trrriple/teensyGpsDoV2/doc/s-l960.webp

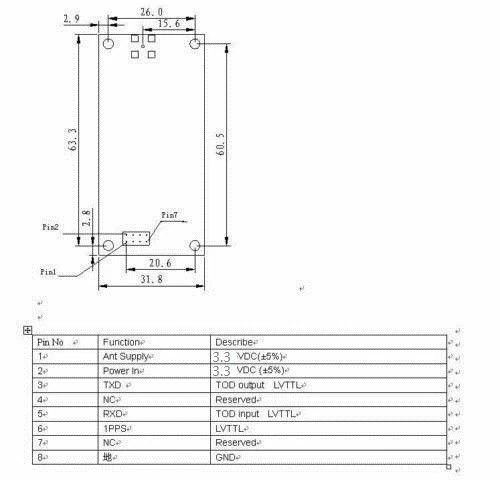
doc/s-l960.webp
