trrriple/teensyGpsDoV2/doc/s-l1600.webp

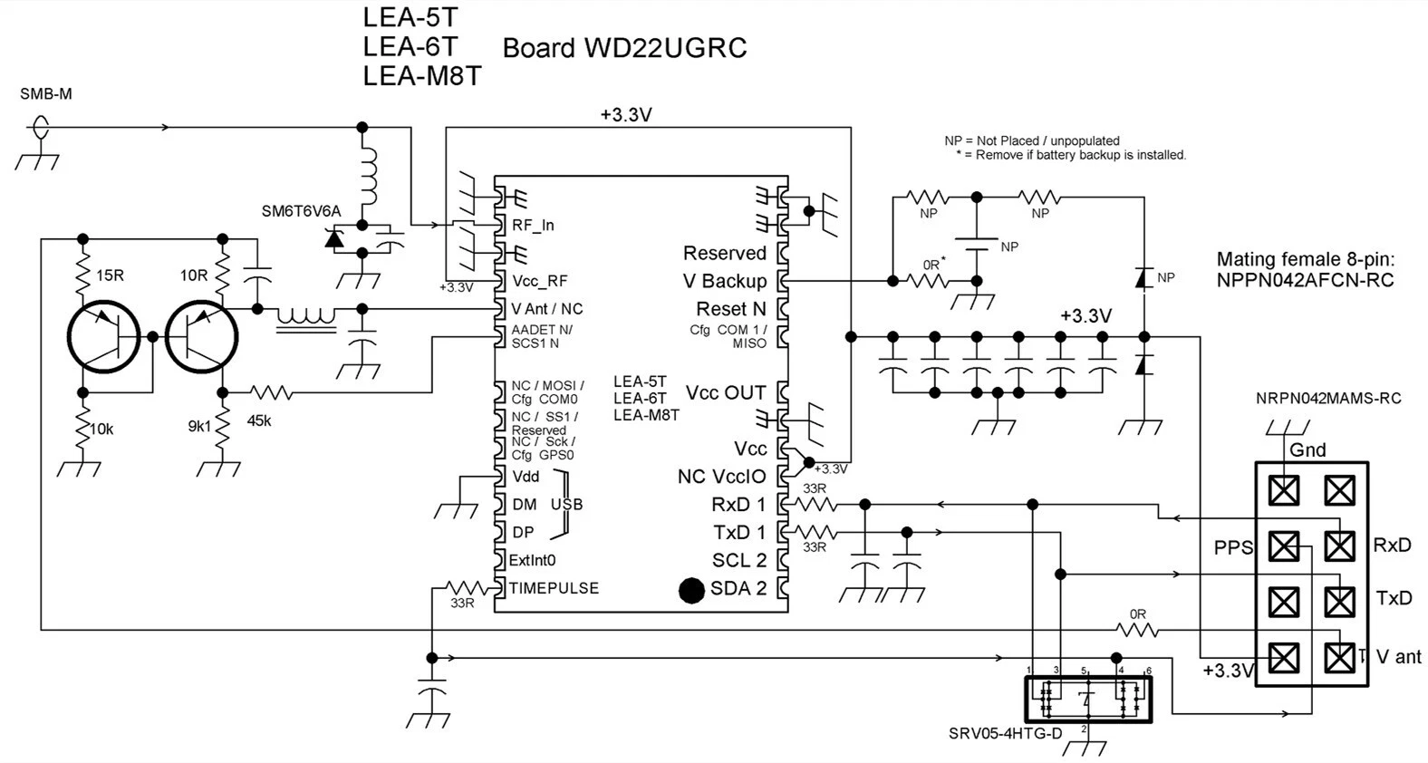
doc/s-l1600.webp
