trrriple/teensyGpsDoV2/board/teensyGpsDoV2/teensyGpsDoV2.kicad_pcb

## KiCad design board/teensyGpsDoV2/teensyGpsDoV2.kicad_pcb (2025-10-29)

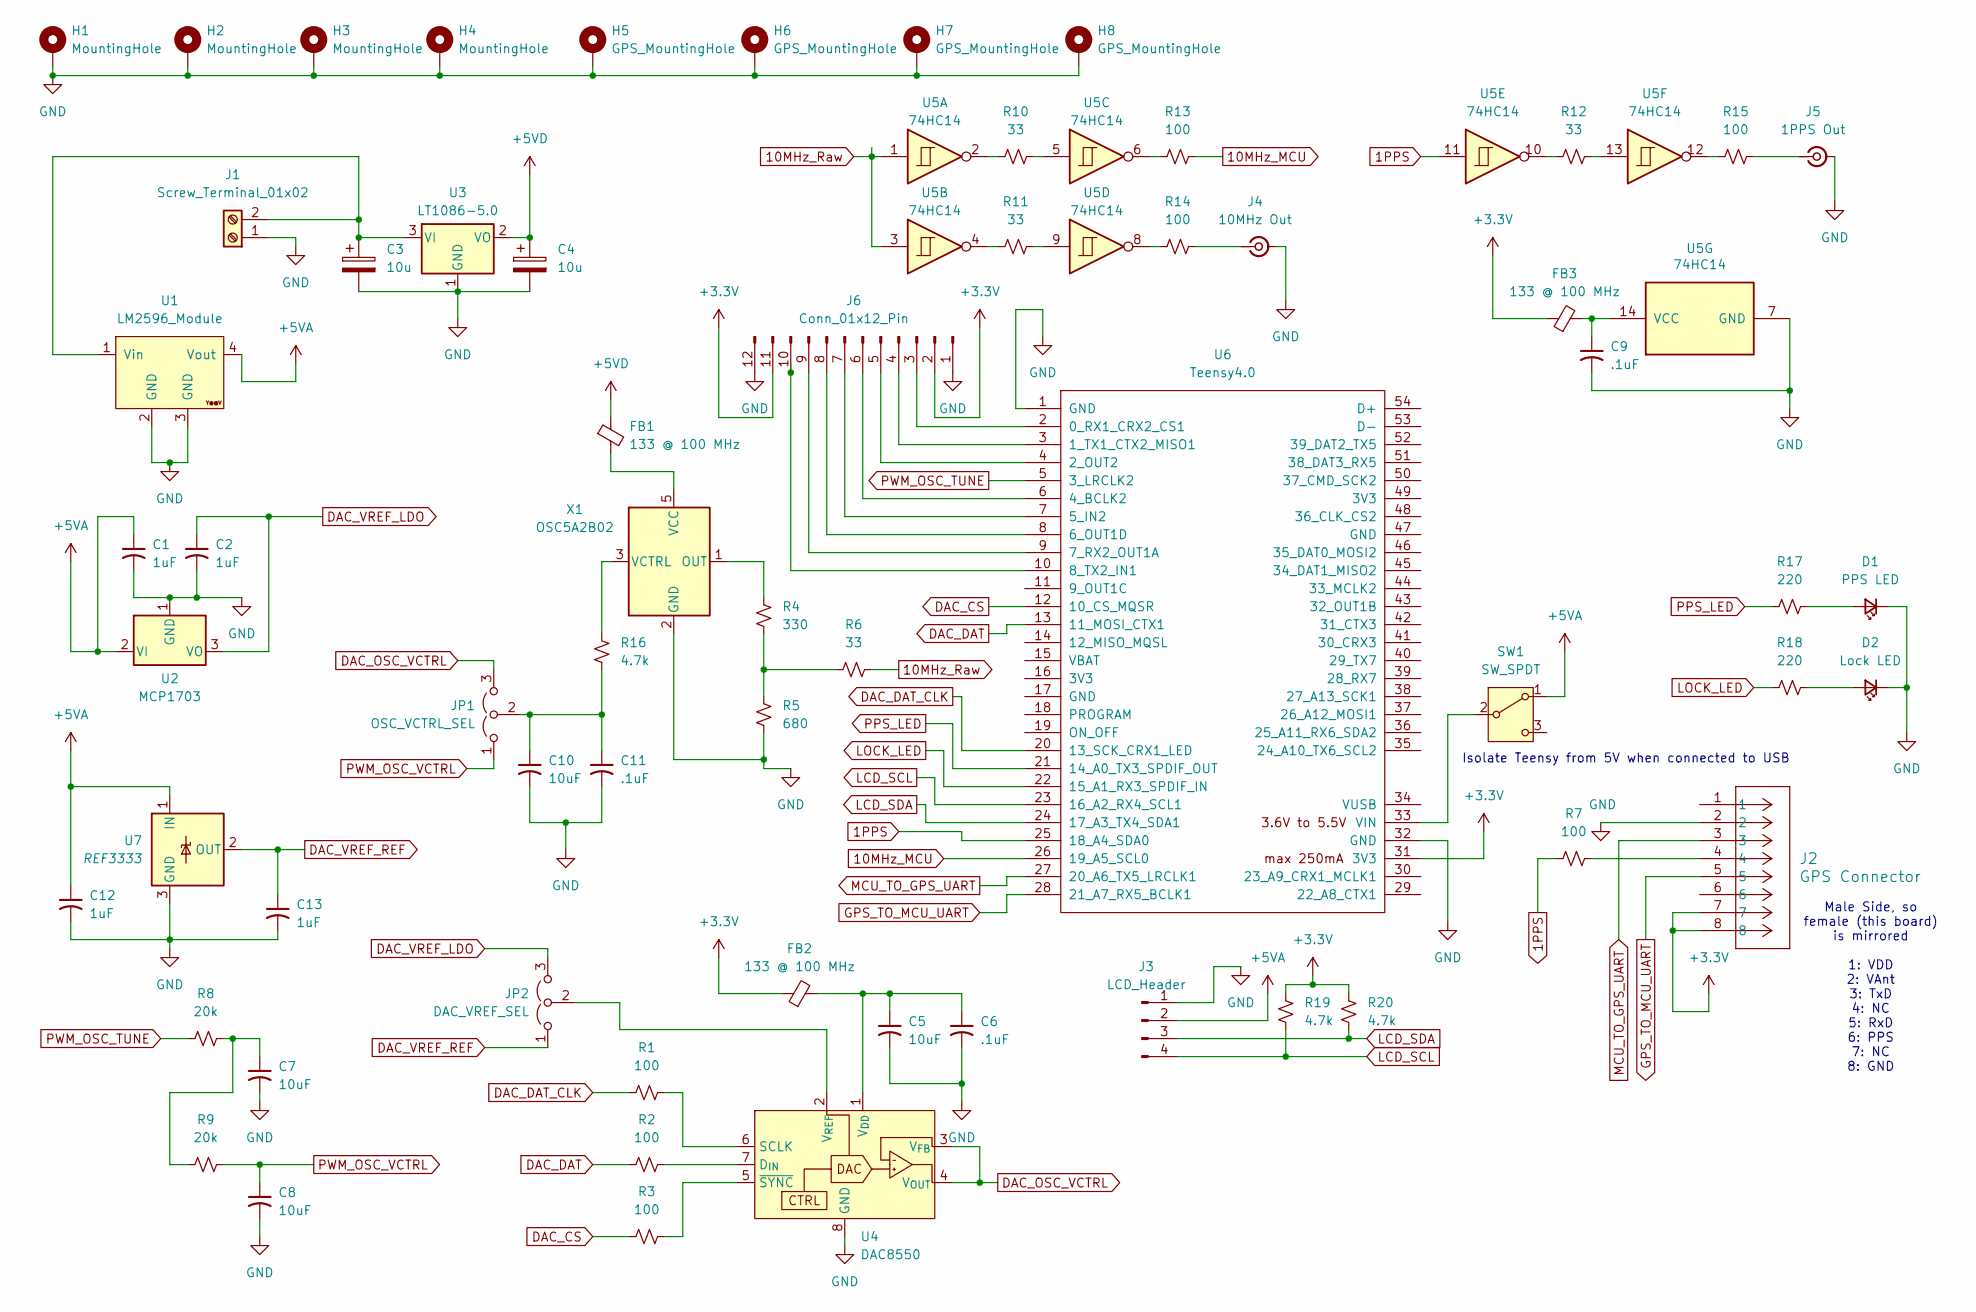
[picture p13: schematic teensyGpsDoV2.kicad_sch]

Parts:
C1, C2, C12, C13: 1uF; C_Disc_D5.0mm_W2.5mm_P5.00mm
C3, C4: 10u; CP_Radial_Tantal_D5.0mm_P5.00mm
C5, C7, C8, C10: 10uF; C_Disc_D5.0mm_W2.5mm_P5.00mm
C6, C9, C11: .1uF; C_Disc_D5.0mm_W2.5mm_P5.00mm
D1: PPS LED; LED_D5.0mm_Clear
D2: Lock LED; LED_D5.0mm_Clear
FB1, FB2, FB3: 133 @ 100 MHz; R_Axial_DIN0411_L9.9mm_D3.6mm_P12.70mm_Horizontal
H1, H2, H3, H4: MountingHole; MountingHole_3.5mm_Pad
H5, H6, H7, H8: GPS_MountingHole; MountingHole_3.2mm_M3_DIN965_Pad
J1: Screw_Terminal_01x02; TerminalBlock_MaiXu_MX126-5.0-02P_1x02_P5.00mm
J2: GPS Connector; CONN4x2_NPPN042AFCN-RC_SUL
J3: LCD_Header; PinHeader_1x04_P2.54mm_Vertical
J4: 10MHz Out; CONN_RF2-04A-T-00-50-G_ADM
J5: 1PPS Out; CONN_RF2-04A-T-00-50-G_ADM
J6: Conn_01x12_Pin; PinHeader_1x12_P2.54mm_Vertical
JP1: OSC_VCTRL_SEL; PinHeader_1x03_P2.54mm_Vertical
JP2: DAC_VREF_SEL; PinHeader_1x03_P2.54mm_Vertical
R1, R2, R3, R7, R13, R14, R15: 100; R_Axial_DIN0207_L6.3mm_D2.5mm_P10.16mm_Horizontal
R4: 330; R_Axial_DIN0207_L6.3mm_D2.5mm_P10.16mm_Horizontal
R5: 680; R_Axial_DIN0207_L6.3mm_D2.5mm_P10.16mm_Horizontal
R6, R10, R11, R12: 33; R_Axial_DIN0207_L6.3mm_D2.5mm_P10.16mm_Horizontal
R8, R9: 20k; R_Axial_DIN0207_L6.3mm_D2.5mm_P10.16mm_Horizontal
R16, R19, R20: 4.7k; R_Axial_DIN0207_L6.3mm_D2.5mm_P10.16mm_Horizontal
R17, R18: 220; R_Axial_DIN0207_L6.3mm_D2.5mm_P10.16mm_Horizontal
SW1: SW_SPDT; PinHeader_1x03_P2.54mm_Vertical
U1: LM2596_Module; YAAJ_DCDC_StepDown_LM2596
U2: MCP1703; TO-92_Inline
U3: LT1086-5.0; TO-220-3_Vertical
U4: DAC8550; VSSOP-8_3x3mm_P0.65mm
U5: 74HC14; DIP-14_W7.62mm_Socket
U6: Teensy4.0; Teensy40
U7: REF3333; SOT-23
X1: OSC5A2B02; CTI-OSC-25x25

Connections:
1PPS: R7.1, U5.11, U6.25 (18_A4_SDA0)
10MHz_MCU: R13.2, U6.26 (19_A5_SCL0)
10MHz_Raw: R6.2, U5.1, U5.3
+3.3V: FB2.1, FB3.1, J2.7, J2.8, J6.2, J6.11, R19.1, R20.1, U6.31 (3V3)
+5VA: C1.1, C12.1, J3.2, SW1.1 (A), U1.4 (Vout), U2.2 (VI), U7.1 (IN)
+5VD: C4.1, FB1.1, U3.2 (VO)
DAC_CS: R3.1, U6.12 (10_CS_MQSR)
DAC_DAT: R2.1, U6.13 (11_MOSI_CTX1)
DAC_DAT_CLK: R1.1, U6.20 (13_SCK_CRX1_LED)
DAC_OSC_VCTRL: JP1.3 (B), U4.3 (V_{FB}), U4.4 (V_{OUT})
DAC_VREF_LDO: C2.1, JP2.3 (B), U2.3 (VO)
DAC_VREF_REF: C13.1, JP2.1 (A), U7.2 (OUT)
GND: C1.2, C2.2, C3.2, C4.2, C5.2, C6.2, C7.2, C8.2, C9.2, C10.2, C11.2, C12.2, C13.2, D1.1 (K), D2.1 (K), H1.1, H2.1, H3.1, H4.1, H5.1, H6.1, H7.1, H8.1, J1.1, J2.2, J3.1, J4.2 (Ext), J5.2 (Ext), J6.1, J6.12, R5.2, U1.2 (GND), U1.3 (GND), U2.1 (GND), U3.1 (GND), U4.8 (GND), U5.7 (GND), U6.1 (GND), U6.32 (GND), U7.3 (GND), X1.2 (GND)
GPS_TO_MCU_UART: J2.5, U6.28 (21_A7_RX5_BCLK1)
LCD_SCL: J3.4, R19.2, U6.23 (16_A2_RX4_SCL1)
LCD_SDA: J3.3, R20.2, U6.24 (17_A3_TX4_SDA1)
LOCK_LED: R18.1, U6.22 (15_A1_RX3_SPDIF_IN)
MCU_TO_GPS_UART: J2.3, U6.27 (20_A6_TX5_LRCLK1)
unnamed: C7.1, R8.1, R9.1
unnamed: D1.2 (A), R17.2
unnamed: D2.2 (A), R18.2
unnamed: C3.1, J1.2, U1.1 (Vin), U3.3 (VI)
unnamed: J2.4, R7.2
unnamed: J4.1 (In), R14.2
unnamed: J5.1 (In), R15.2
unnamed: J6.3, U6.2 (0_RX1_CRX2_CS1)
unnamed: J6.4, U6.3 (1_TX1_CTX2_MISO1)
unnamed: J6.5, U6.4 (2_OUT2)
unnamed: J6.6, U6.6 (4_BCLK2)
unnamed: J6.7, U6.7 (5_IN2)
unnamed: J6.8, U6.8 (6_OUT1D)
unnamed: J6.9, U6.9 (7_RX2_OUT1A)
unnamed: J6.10, U6.10 (8_TX2_IN1)
unnamed: C10.1, C11.1, JP1.2 (C), R16.2
unnamed: JP2.2 (C), U4.2 (V_{REF})
unnamed: R4.2, R5.1, R6.1
unnamed: R10.1, U5.2
unnamed: R10.2, U5.5
unnamed: R11.1, U5.4
unnamed: R11.2, U5.9
unnamed: R12.1, U5.10
unnamed: R12.2, U5.13
unnamed: R13.1, U5.6
unnamed: R14.1, U5.8
unnamed: R15.1, U5.12
unnamed: SW1.2 (B), U6.33 (VIN)
unnamed: R2.2, U4.7 (D_{IN})
unnamed: R1.2, U4.6 (SCLK)
unnamed: C5.1, C6.1, FB2.2, U4.1 (V_{DD})
unnamed: R3.2, U4.5 (~SYNC)
unnamed: C9.1, FB3.2, U5.14 (VCC)
unnamed: R4.1, X1.1 (OUT)
unnamed: FB1.2, X1.5 (VCC)
unnamed: R16.1, X1.3 (VCTRL)
PPS_LED: R17.1, U6.21 (14_A0_TX3_SPDIF_OUT)
PWM_OSC_TUNE: R8.2, U6.5 (3_LRCLK2)
PWM_OSC_VCTRL: C8.1, JP1.1 (A), R9.2

Notes on the sheet:
Male Side, so female (this board) is mirrored 1: VDD 2: VAnt 3: TxD 4: NC 5: RxD 6: PPS 7: NC 8: GND
Isolate Teensy from 5V when connected to USB

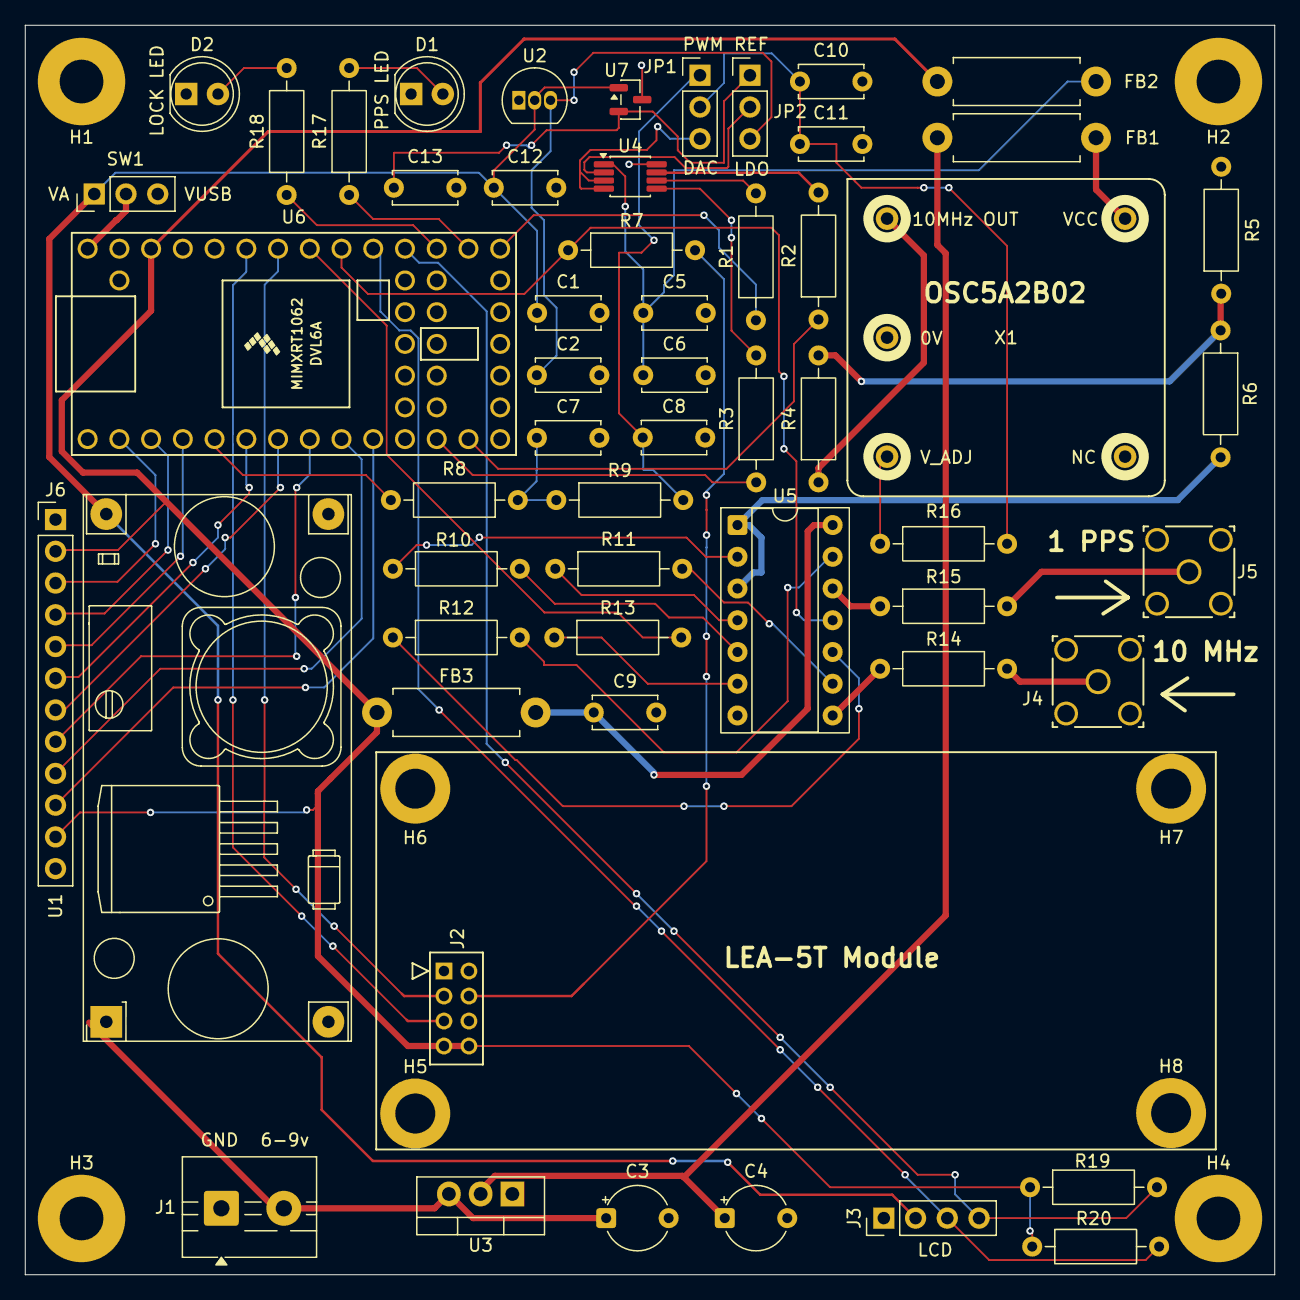
[picture p14: board teensyGpsDoV2.kicad_pcb from above]

Board: 2 copper layers, 100.0 x 100.0 mm, 63 parts (0 on the bottom side), 57 nets.
