trrriple/teensyGpsDoV2/(commit log)

2025-10-19 WIP, dac8550 and oscillator tuning implemented. Tuning filter probably needs some work
    [gnss_ubx5.cpp, gnss_ubx5.h, main.cpp]
2025-10-20 WIP schematic, WIP tuning code
    [teensyGpsDoV2.kicad_pcb, teensyGpsDoV2.kicad_sch]
2025-10-20 rework to use quad timer capture instead of interrupt
    [main.cpp]
2025-10-21 fixed bug with counter reset value, unifying console printing to one function
    [main.cpp]
2025-10-21 Schematic WIP
    [teensyGpsDoV2.kicad_sch]
2025-10-23 WIP, moved libraries to allow wire1 instead of wire modification. Lots of tuning. LCD optimations
    [teensyGpsDoV2.kicad_sch]
2025-10-27 mobile update
    [teensyGpsDoV2.kicad_sch]
2025-10-27 wip on schematic. Added PWM option instead of DAC
    [teensyGpsDoV2.kicad_sch]
2025-10-28 layout wip
    [teensyGpsDoV2.kicad_pcb, teensyGpsDoV2.kicad_sch]
2025-10-28 wip schematic, routing
    [teensyGpsDoV2.kicad_pcb, teensyGpsDoV2.kicad_sch]
2025-10-29 schematic routing done, allegedly
    [teensyGpsDoV2.kicad_pcb, teensyGpsDoV2.kicad_sch]
2025-10-29 revision 1.0 submitted for manufacturing
    [teensyGpsDoV2.kicad_pcb]
2025-11-07 fix PWM to be on correct pin
    [main.cpp]
